cklit/BeogramAdaptor/README.md

# BGAdaptor
The BGAdaptor connects a vintage Data Link source (**Beogram/Beogram CD/Beocord**) to a
modern Bang & Olufsen product, turning it into a fully integrated source:
- Select Line-in and the Data Link source starts playing
- Switch source and it stops
- Send the product to standby and the Data Link source turns off.

Your Data Link source behaves like a native source — controllable from the product itself, the B&O
app, a Beoremote One or a Beoremote Halo (next and previous is unfortunately not possible from the B&O app).

Under the hood, an ESP32 microcontroller monitors your B&O product over the network and translates its state into Data Link
commands. See more info below.

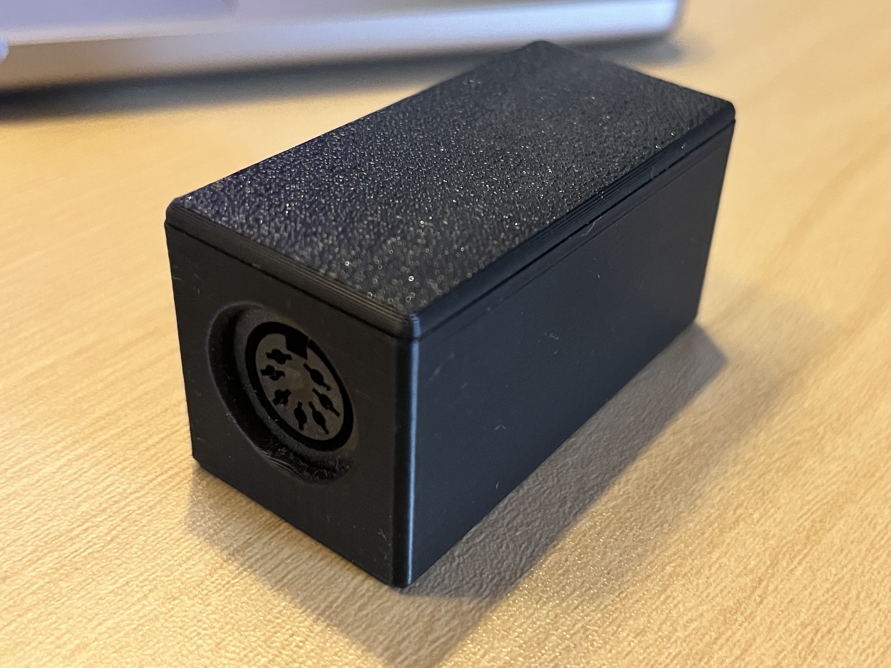
[picture p1: images/beogram_adaptor.jpeg]


### Compatible with all Bang & Olufsen Connected Audio products that feature a Line-in source.
See this article for <a href="https://support.bang-olufsen.com/hc/en-us/articles/24766979863441-Which-platform-is-my-Connected-Audio-product-based-on">compatible products</a>.<br>
- Both ASE and Mozart Platform-based products are supported, as long as they feature a Line-in input.
- Be aware that Beosound 1 and Beosound A5 does not feature a Line-in input.
- Some Mozart Platform-based products require an optional passive USB-C to 3.5mm jack adaptor for Line-in.
- Products with Google Assistant are **not** supported.

### Compatible with Data Link sources (7-pin DIN):

**Supported record players that feature Data Link and a built-in RIAA pre-amp:**
- Beogram 3500
- Beogram 4500
- Beogram 6500
- Beogram 7000

_If your Data Link-capable Bang & Olufsen record player does not include a built-in RIAA pre-amp, it is possible to use a OneRemote riaa with Data Link passthrough (Example: https://shop.oneremote.dk/shop/69068-riaa-forstaerker/121270-riaa-iii-forforstaerker)_

**Supported CD players that feature Data Link:**
- Beogram CD 50
- Beogram CD 3300
- Beogram CD 3500
- Beogram CD 4500
- Beogram CD 5500
- Beogram CD 6500
- Beogram CD 7000

**Supported tape decks that feature Data Link:**
- Beocord 3500
- Beocord 4500
- Beocord 5000
- Beocord 5500
- Beocord 6500
- Beocord 7000
- and others....

# How does it work?
Physically, the BGAdaptor is a female 7-pin DIN to male 3.5mm jack
adaptor with a small piece of electronics built in. The Data Link source plugs into
the DIN end, and a jack cable is connected between the adaptor and the Line-in input of your network connected Bang & Olufsen product.

Inside the BGAdaptor, an ESP32 board is connected to the Data Link source's data pins. The ESP32 connects to your WiFi network and listens to the event stream
from your Bang & Olufsen product — similar to how the B&O app receives feedback from it. This is how the adaptor knows which source is active, and
when to send play, stop and standby commands to the Data Link source.

Communication over Data Link is bidirectional: the adaptor sends
commands, but also receives status back from the source, such as playing
state and, for CD players, the current track number.
_Please note that record players do not report if the needle is lifted. Only Playing and Stopped._

The ESP32 is powered by a separate USB power supply or an available USB port of your Bang & Olufsen product (if applicable).

**Principle (analogue audio or digital audio):**

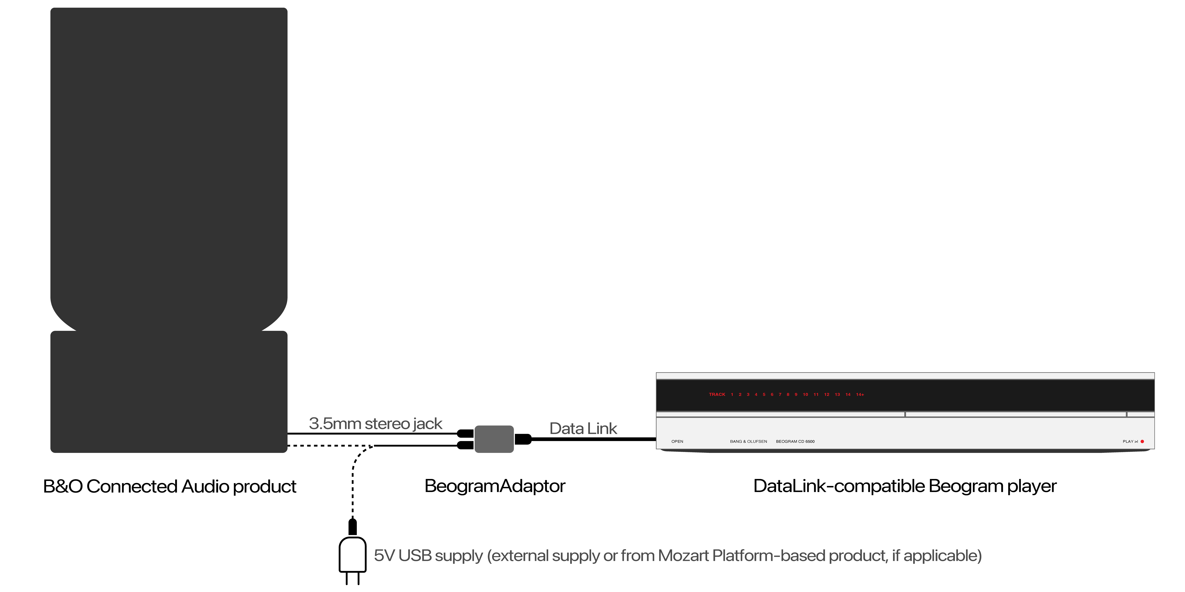
[picture p2: images/connection_analogue_connection.png]
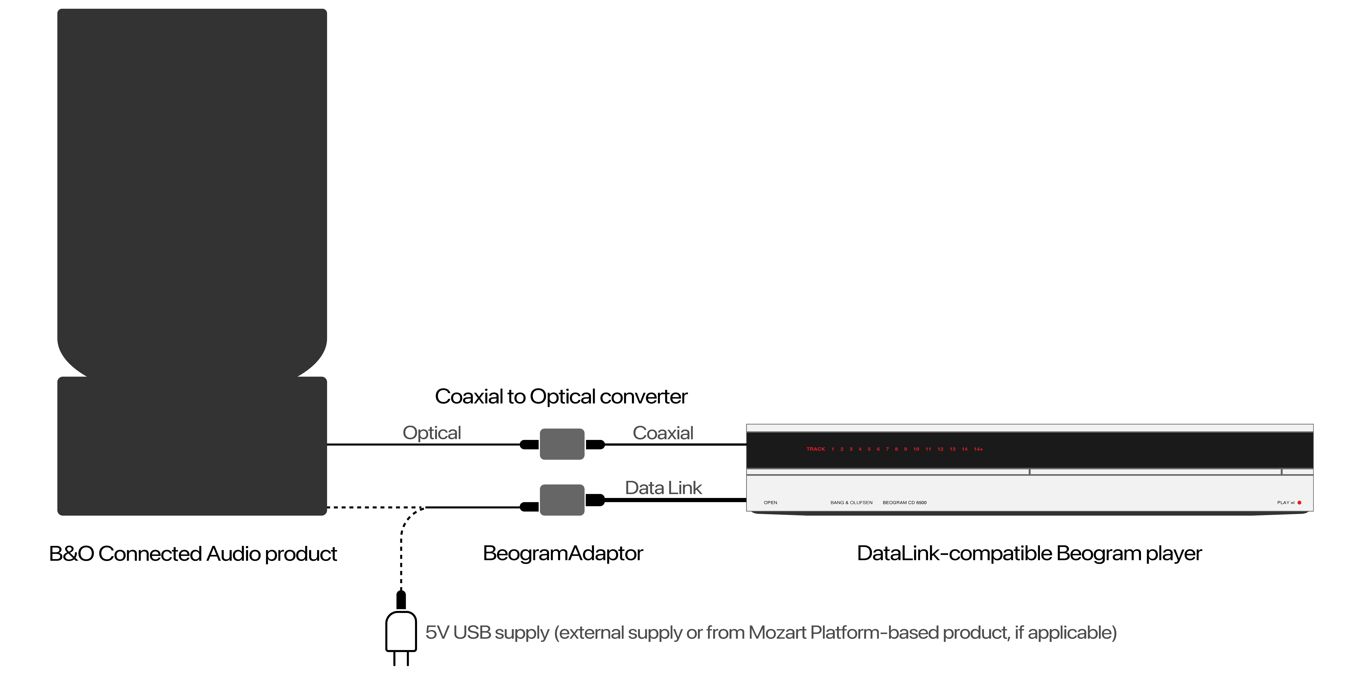
[picture p3: images/connection_digital_connection.png]


---

# Setup

Once it is powered on it will start a Soft AP, which allows you to add the credentials to your own WiFi network.

SSID: **BGAdaptor** <br>
Password: **password**

Once your mobile device is connected, a captive portal will open automatically, where you can enter the credentials for your home WiFi network.

When connected, enter _beogram.local_ in your browser. It is possible to activate commands on the Data Link source directly from this page. 

Next, we can to connect to our network connected Bang & Olufsen product.
In the Settings section, tap Show.

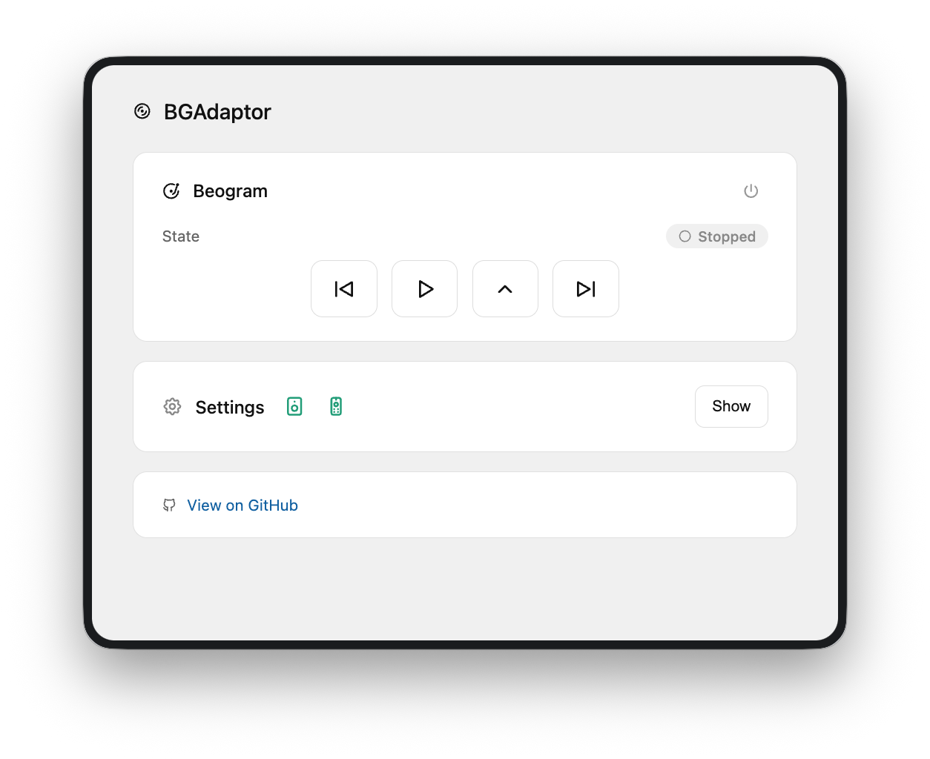
[picture p4: screenshots/bgadaptor_bg.png]
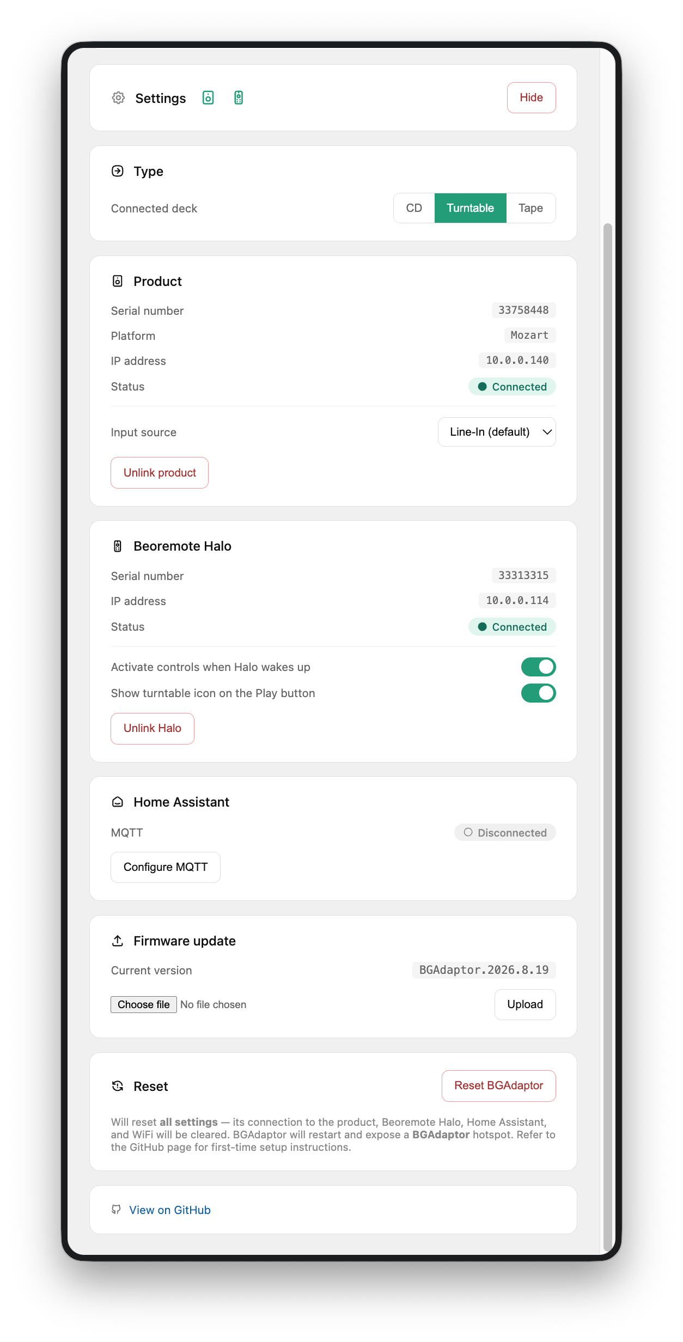
[picture p5: screenshots/bgadaptor_settings.png]

In the Type section, you define what kind of source you have connected. The UI will change accordingly.

In the product selector field, you will find a dropdown menu. <br>To scan your network for compatible Bang & Olufsen speakers, press the **Start product scan** button - this scan takes around 10 seconds. <br>Once completed the list should be populated with your products. <br>Select the product that the BGAdaptor should connect to in the dropdown menu. <br>Press the green **Connect** button (BGAdaptor will quickly restart if switching from an ASE-based to a Mozart-based product or vice versa).

Once connected the BGAdaptor will monitor the event stream from the product.

In the section below the product selector, you can choose to connect to a Beoremote Halo to get player controls. <br><br>
Lastly, you can also enter your MQTT credentials on the dedicated MQTT setup page for easy connection to Home Assistant. This will expose player controls, playing state, and track number (only relevant for CD players) to Home Assistant.<br>
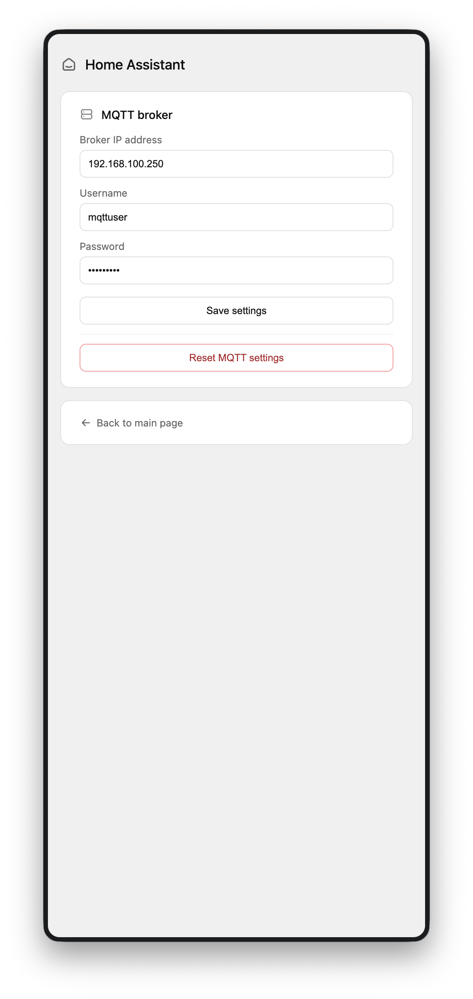
[picture p6: screenshots/bgadaptor_mqtt.png]
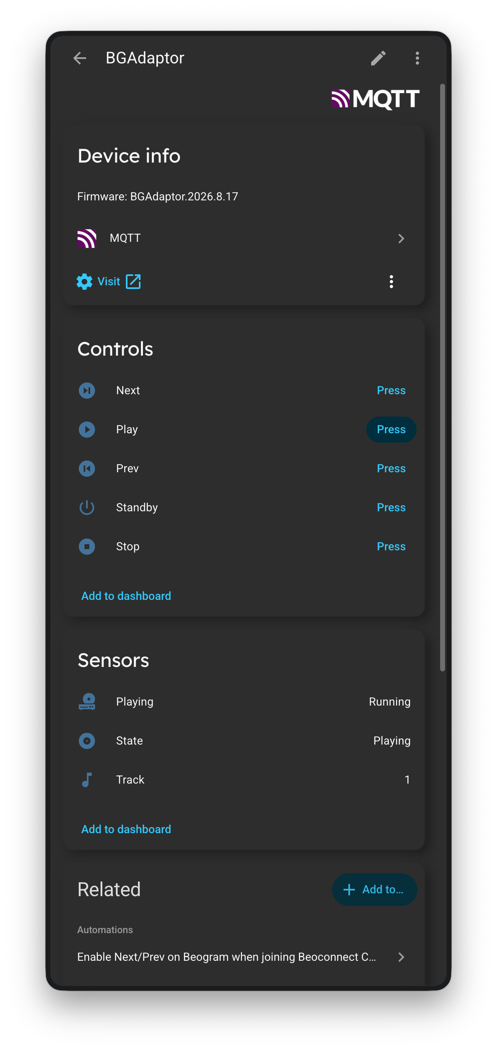
[picture p7: screenshots/bgadaptor_home_assistant.png]


---

# Usage and limitations
Now you are ready to use the system.
You can start the Data Link source from the Connected Audio product, the app, a Beoremote Halo and/or a Beoremote One BT by selecting the **Line-in** source.
A short demo of the different possibilities can be found here: https://youtu.be/YJ0Ucw3CIwc 

Changing source away from Line-in will send a STOP command to the Data Link source (pause, basically). 

Activating Line-in again will send PLAY and resume from the point where you left off (note: the Data Link source will automatically turn off after a few minutes in STOP-mode).

Sending a Standby or All-standby to the product from any interface will turn off the record player.

### Control using a Beoremote One BT:
With a connected Beoremote One BT you can do basic control of the connected Data Link source. 

1. Activate Line-in to start the Data Link source.
2. Press List on Beoremote One BT and ensure that **Control** is highlighted in the remote list
3. Press ▶, ⏸, ⏮ or ⏭ to control the Data Link source
    - If a Beogram CD player is connected, it is also possible to use the digit keys to change to a specific track   

It is **not** possible to change track using the Bang & Olufsen app. Neither is it possible to change track from another room that has joined the experience.

### Control using a Beoremote Halo (OPTIONAL)
You can connect a Beoremote Halo to the BGAdaptor from the webpage (_beogram.local_). This will create a custom page on the Halo for Next, Previous and Play/Pause control of the Data Link source.

If a Beogram CD player is connected, it will also show the currently playing track.

_If you already is utilising the custom pages, e.g. through a Beoliving Intelligence, do not add your Halo to the BGAdaptor. Halo can only connect to one client at a time._

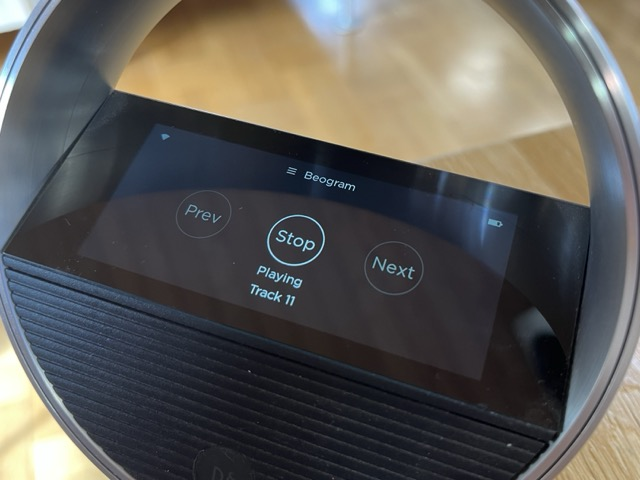
[picture p8: screenshots/Halo_controls.jpeg]


### Mozart Platform only: Controls directly on the product: 
Play, Pause, Next and previous works directly on a Mozart product (the < and > buttons are turned off when using Line-in, but they will still work). 

# REST calls
For testing or integration with a control system, you can send commands directly to the Data Link source. I highly recommend using the IP address instead of beogram.local for these requests, as DNS lookup slows things down significantly.

Example: ```curl --location --request POST 'http://192.168.100.37/command/next'```

| Command | Method | Endpoint |
| --- | --- | --- |
| Play | POST | <ip>/command/play |
| Stop | POST | <ip>/command/stop |
| Next | POST | <ip>/command/next |
| Previous | POST | <ip>/command/prev |
| Standby | POST | <ip>/command/standby |

---

# Technical details

# Hardware
Since the Data Link bus is running on 5V and an ESP32 accepts 3.3V on the GPIO pins, we need to add a little hardware. Also, Data Link is sending and receiving on the same wire, so we needed to do some trickery to get communication in both directions.

I have built my prototype using:
- 1x Lolin S3 Mini (https://www.aliexpress.com/item/1005005449219195.html)
- 1x LM358N op-amp
- 1x EL817 optocoupler
- 1x 330ohm resistor
- 1x 1K resistor
- 2x 10K resistors
- 1x female DIN7 (or 8) plug
- 1x stereo jack connector

Diagram:

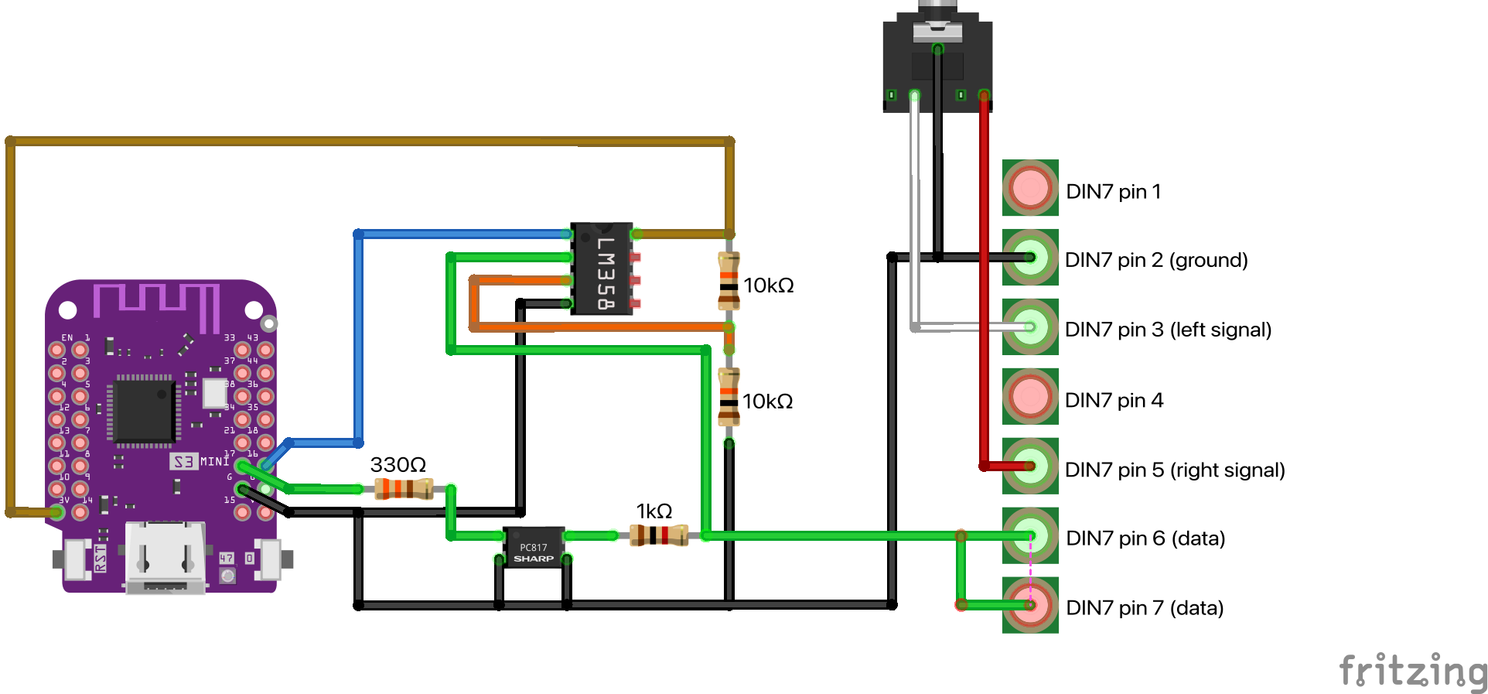
[picture p9: schematics/breadboard_diagram.png]
Diagram


# How to install
If you have an existing BGAdaptor and you want to update the board, go to _beogram.local_ and update using the OTA-release files from this repository.

**The description below does not match the latest versions. I will update this later.**

<s>If you want to install the BGAdaptor from scratch on a Lolin S3 Mini board, download the release package (.zip), which includes 4 .bin files.

Connect your Lolin S3 Mini board to your computer via USB, and go to https://espressif.github.io/esptool-js/ (you must use the Chrome browser).

In the Program field, ensure that the Baudrate is set to 921600. Press **Connect**. Select your ESP32 (mine is called cu.usbmodem1101, but YMMV), and press **Connect**.

Now a new field appears: **Flash Address**. In the right-hand side you can select a file. We need 4 lines filled out exactly as shown below. For each line, press **Add file.**

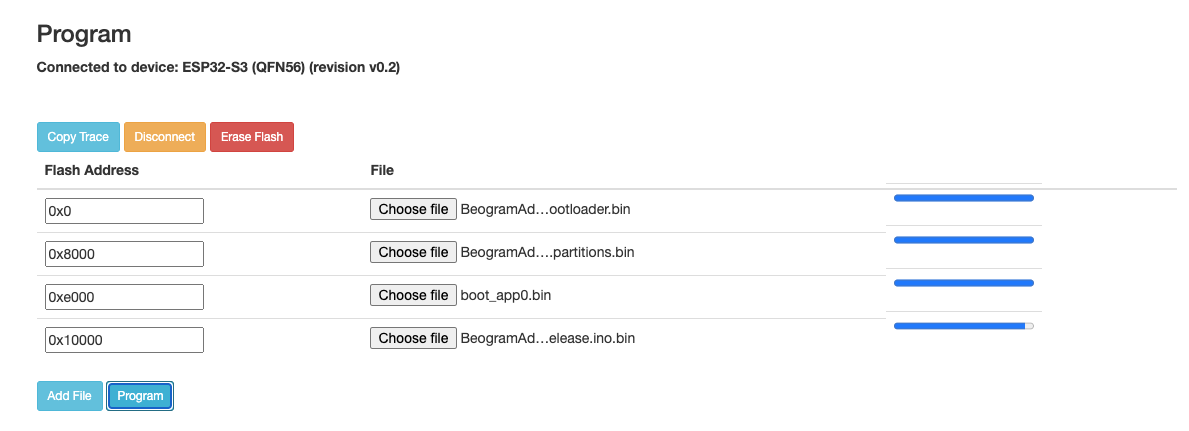
[picture p10: screenshots/flashing-tool.png]


| Flash address | File |
| --- | --- |
| 0x0 | x.bootloader.bin |
| 0x8000 | x.partitions.bin |
| 0xe000 | boot_app0.bin |
| 0x10000 | x.release.bin |

Once this is filled out, press the **Program** button. The flashing process usually takes around 30 seconds.</s>
