cklit/BeogramAdaptor/schematics/schematics.png

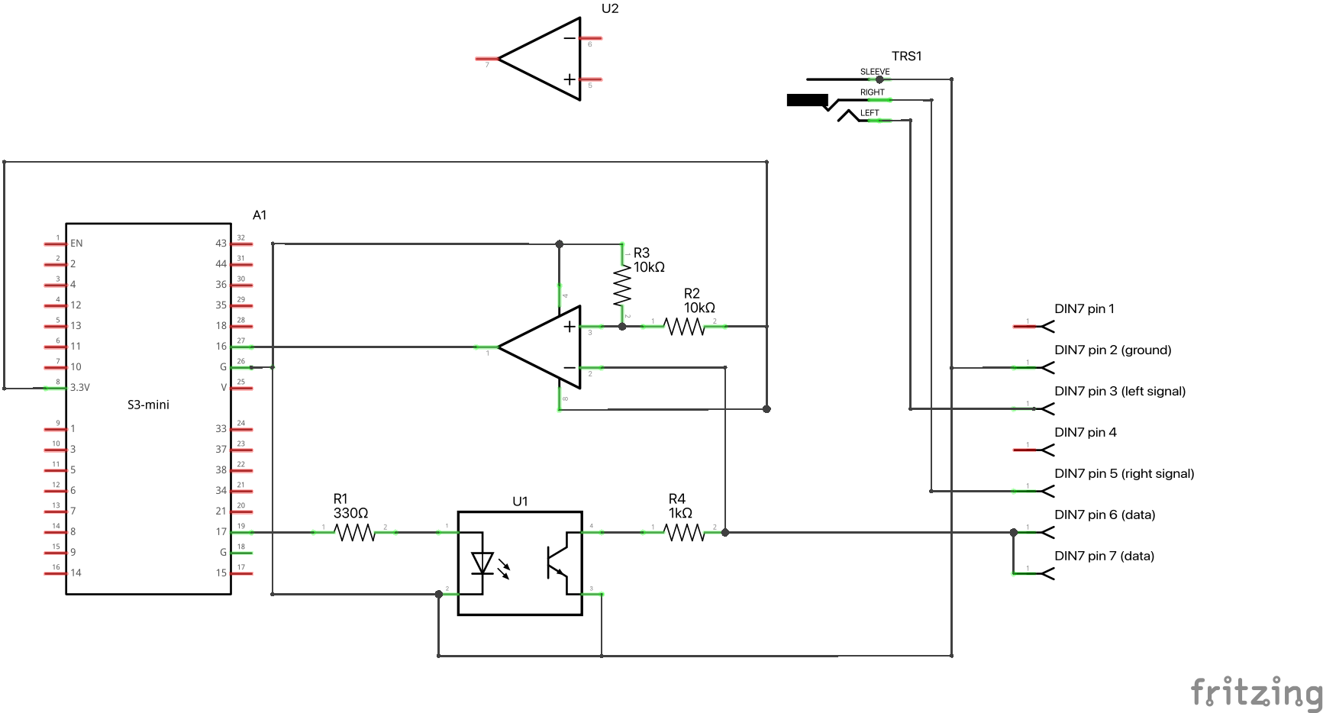
schematics/schematics.png
