cklit/BeogramAdaptor/screenshots/bgadaptor_connected.png

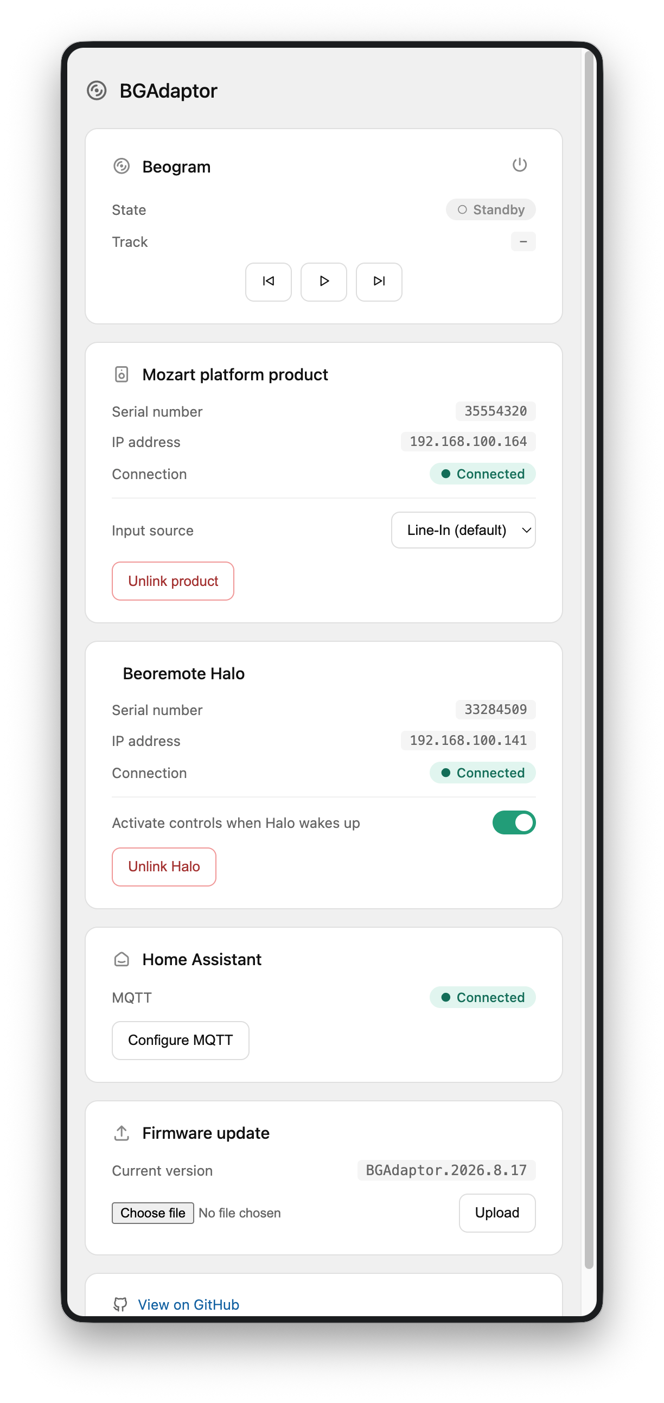
screenshots/bgadaptor_connected.png
