cklit/BeogramAdaptor/screenshots/bgadaptor_fts.png

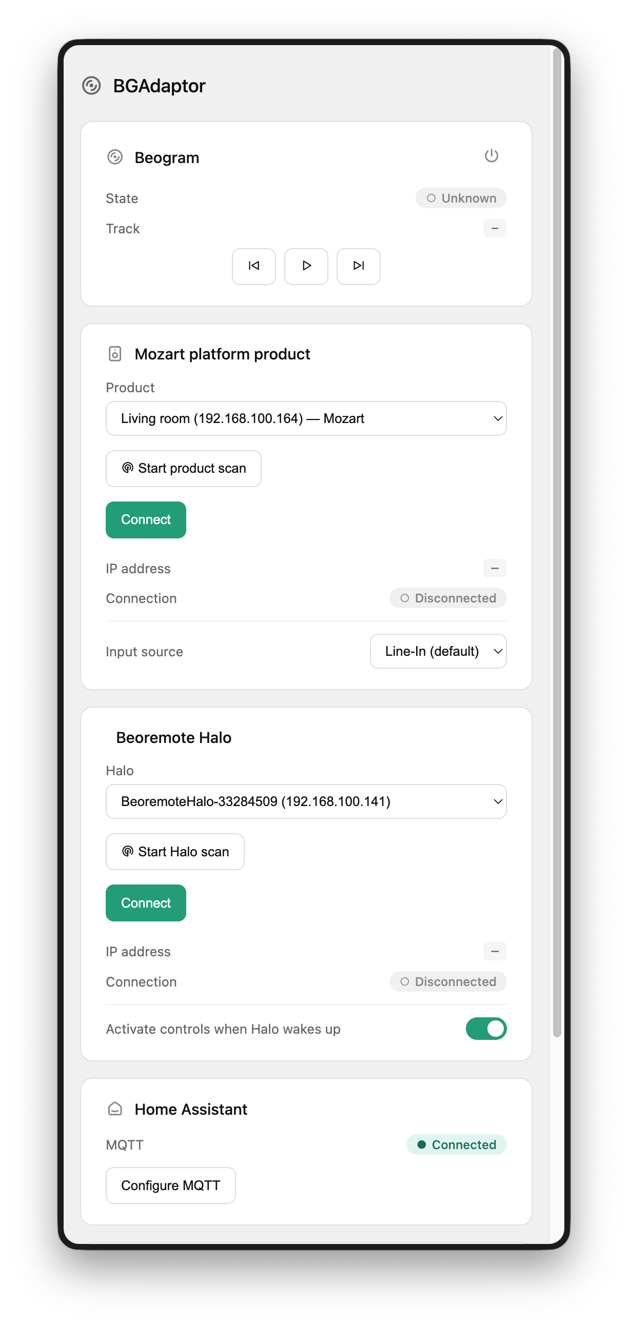
screenshots/bgadaptor_fts.png
