cklit/BeogramAdaptor/screenshots/frontpage.png

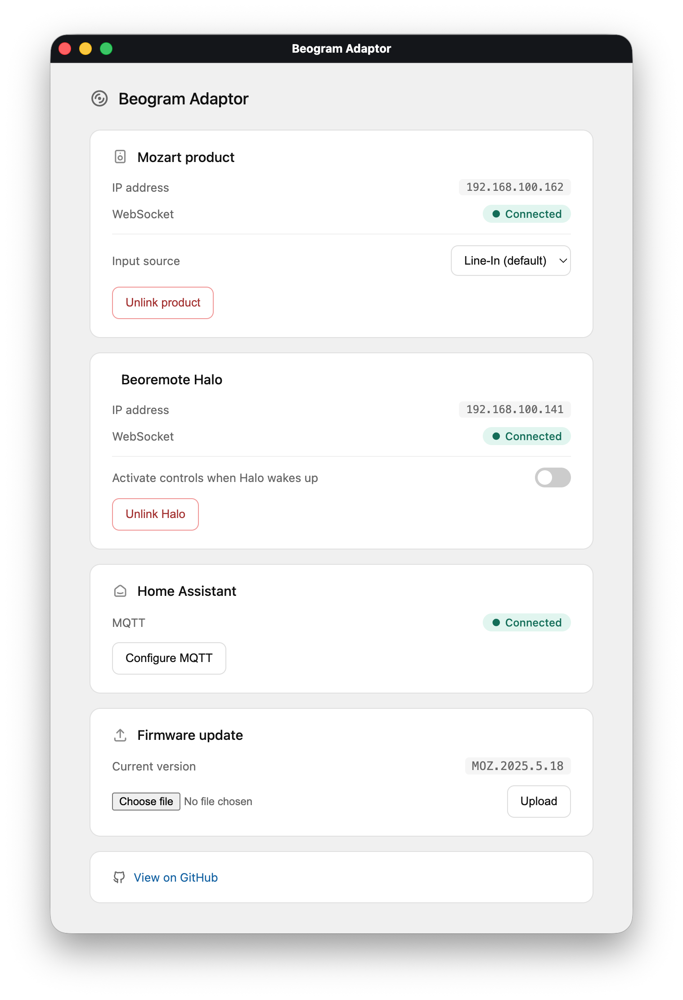
screenshots/frontpage.png
