cklit/BeogramAdaptor/BGAdaptor/src/halo.h

#pragma once
#include "state.h"

// Beoremote Halo: websocket client, configuration JSON, wheel/button
// event handling, and display page/button updates.

// Halo page and button identifiers (UUIDs the Halo config declares).
extern const char* const HALO_PAGE_ID;
extern const char* const HALO_BTN_PREV;
extern const char* const HALO_BTN_PLAY;
extern const char* const HALO_BTN_STOP;    // record player mode only
extern const char* const HALO_BTN_NEXT;
extern const char* const HALO_BTN_STANDBY;

struct ButtonUpdate {
    String id;
    bool pending;
    unsigned long timestamp;
};
extern ButtonUpdate pendingUpdate;  // Track pending button updates

void sendButtonIconUpdate(const char* buttonID, const char* icon, const char* title = nullptr, const char* subtitle = nullptr);
void sendButtonUpdate(const char* buttonID, const char* state = nullptr, const char* title = nullptr, const char* text = nullptr, const char* subtitle = nullptr, int value = -1);
void sendPageUpdate(const char* pageID, const char* buttonID);
void sendConfigToHalo();
void onMessageCallback(WebsocketsMessage message);
void secondButtonUpdate();
void connectToHalo();
void activateHaloPage();

// Reflect playback state on the Halo. Handles both layouts: the CD
// toggle button and the record player's separate Play/Stop pair.
void updateHaloPlayback(bool playing, const char* subtitle = nullptr);
void updateHaloSubtitle(const char* subtitle);
