cklit/BeogramAdaptor/(commit log)

2025-03-07 Ensure that product reconnects automatically after mains reset
    [BeogramAdaptor_Moz.ino]
2025-03-07 Fix remote ws reconnection
    [BeogramAdaptor_Moz.ino]
2025-03-17 Removed unnecessary Stop command that interrupts multiroom experience
2025-03-27 Update BeogramAdaptor_Moz.ino
    fix certain cd tracks not being recognised
    [BeogramAdaptor_Moz.ino]
2025-03-27 Update BeogramAdaptor_ASE.ino
    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
    [BeogramAdaptor_ASE.ino]
2025-07-02 Attempted fix to connect multiple beogram adaptors to HA
    Trying to add unique entity ids
    [BeogramAdaptor_Moz.ino]
2026-03-12 Roll-back. Edited the wrong file
    [BeogramAdaptor_ASE.ino]
2026-03-12 Improve JSON parsing error handling
    Add error handling for JSON deserialization.
    [BeocordAdaptor_ASE.ino]
2026-03-12 Update firmware version and enhance button handling
    Updated firmware version and modified button names. Added MAC address handling and improved MQTT connection logic.
2026-03-12 Rename buttons for next and previous actions
2026-03-19 Update firmware version and refactor button IDs
    MAC address was not fetched correctly for naming of MQTT entities
    [BeogramAdaptor_Moz.ino]
2026-03-19 Refactor device ID handling and button initialization
2026-03-19 Set configuration URL for device
    Add configuration URL to device setup
2026-03-19 Update firmware version and refactor feedback handling
    Updated firmware version and removed unused track feedback constants. Adjusted button initialization and state handling for playback feedback.
2026-03-19 Refactor BeocordAdaptor for firmware update and feedback
    Updated firmware version and removed unused track feedback enums. Simplified feedback handling for playback states.
2026-04-27 Refactor line-in activation logic in BeocordAdaptor_ASE
    Trying to avoid false triggers on reconnect
    [BeocordAdaptor_ASE.ino]
2026-07-05 ASE: Removed unused stuff and fixed block behaviour on wifi reconnect Moz: Fixed blocking behavior on wifi reconnect
    [main.cpp]
2026-08-12 Revise README for clarity and additional details
    Updated README with supported devices and setup instructions.
2026-08-12 Clarify BeogramAdaptor functionality in README
    Updated the README to clarify the functionality and components of the BeogramAdaptor, including details about the ESP32 connection and power requirements.
2026-08-15 Fixed ASE reconnect mechanism
    ASE would not restart SSE stream when the product was disconnected abruptly (mains reset).
    [config.h, state.cpp, state.h, transport_ase.cpp]
2026-08-18 Reverted to discrete play and stop buttons on the webpage.
2026-08-18 Fixed alignment of upload button
    [config.h]
2026-08-18 Added reset button
2026-08-19 Remove external dependencies. Added button to show turntable icon when Turntable deck is selected.
2026-08-19 Fix blocking behavior of offline mqtt server.
    [config.h, ha_mqtt.cpp, main.cpp, state.cpp, state.h, transport_ase.cpp, transport_moz.cpp]
2026-08-19 Fix formatting and add details for Data Link devices
    Correct formatting and add missing information about supported tape decks and controls.
2026-08-20 Added Reset Wifi button.
    [config.h, webui.cpp]
2026-08-20 Keep track-status on pause
